HuynhMinhDangTDT/Final_project_iot_smart_home/Thuyet trinh do an tot nghiep2.pptx

## BẢO VỆ ĐỒ ÁN TỐT NGHIỆP

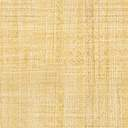
[picture p3: figure]

Tên đề tài:
THỰC HIỆN ỨNG DỤNG Iot TRONG NHÀ THÔNG MINH

GIẢNG VIÊN HƯỚNG DẪN: ThS. Nguyễn Quang Dũng
Người thực hiện : Huỳnh Minh Đăng

## II. Mục đích nghiên cứu

- Thiết kế ra thiết bị IoT có khả năng điểu khiển thông qua internet.
- Thiết kế trang web điều khiển
- Thiết kế app điều khiển
- Thiết kế màn hình hiển thị điều khiển
- Thiết kế phần mềm kết nối camera CCTV nhận diện đám cháy bằng công nghệ AI nhận diện thời gian thực.

## III. Thiết kế đề tài

- Mạch điều khiển IoT

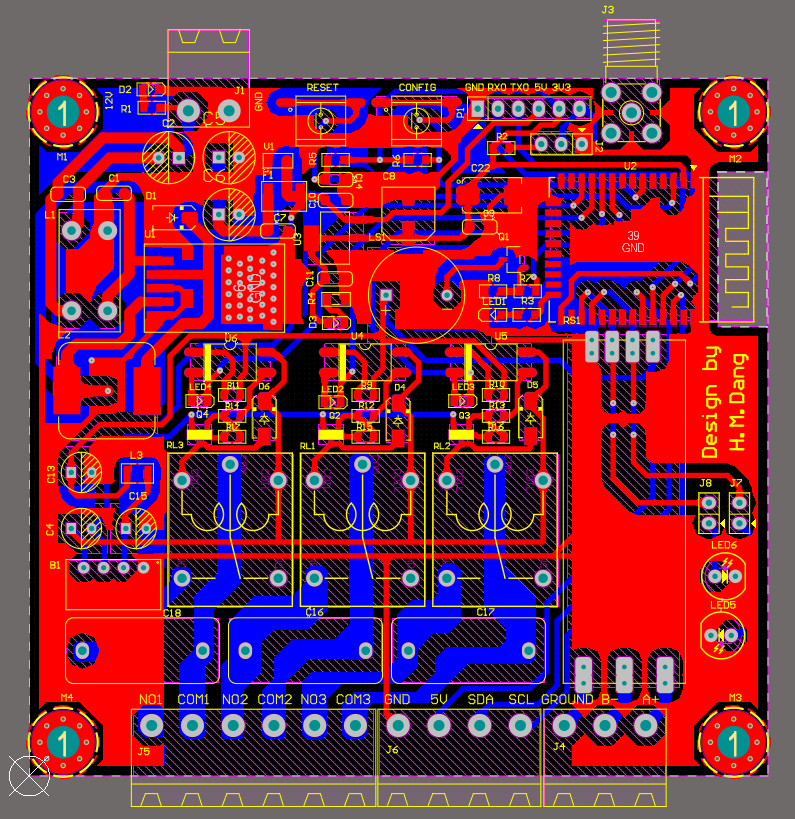
[picture p4: figure]

Phiên bản 1

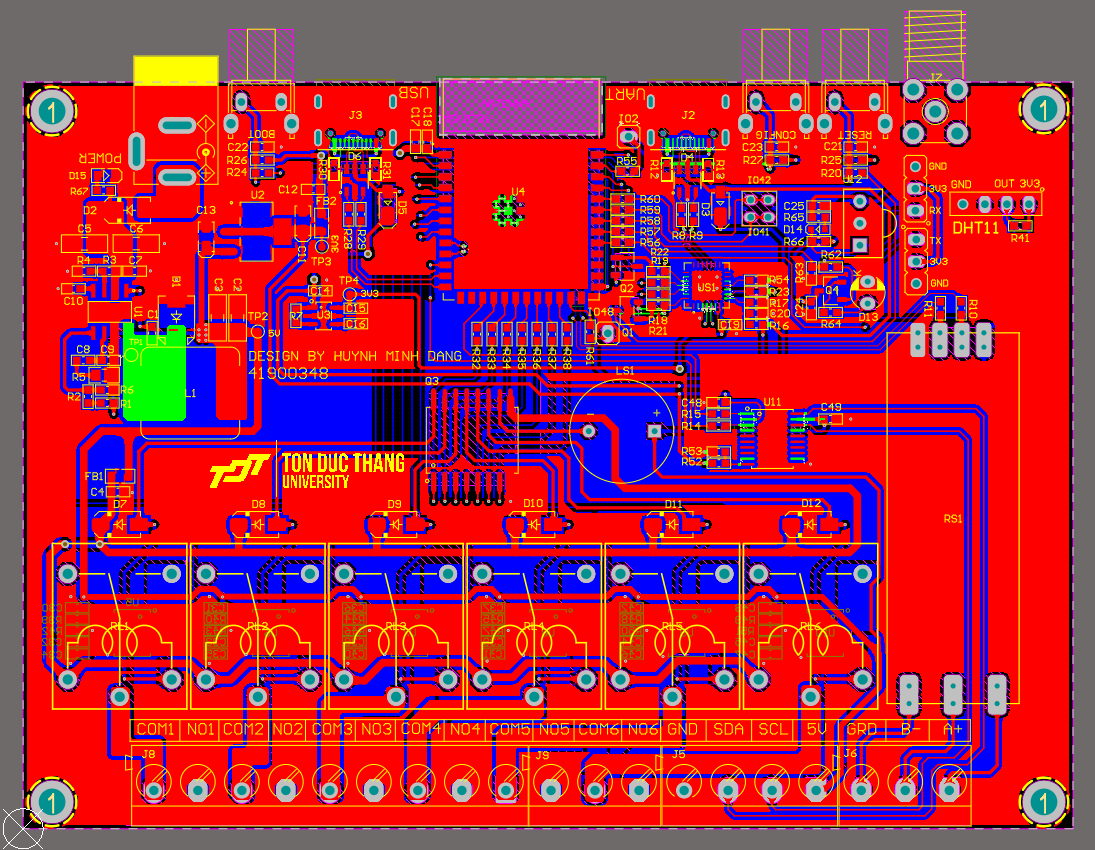
[picture p5: figure]

Phiên bản 2

## II. Thiết kế đề tài

- Mạch thực tế hoàn chỉnh

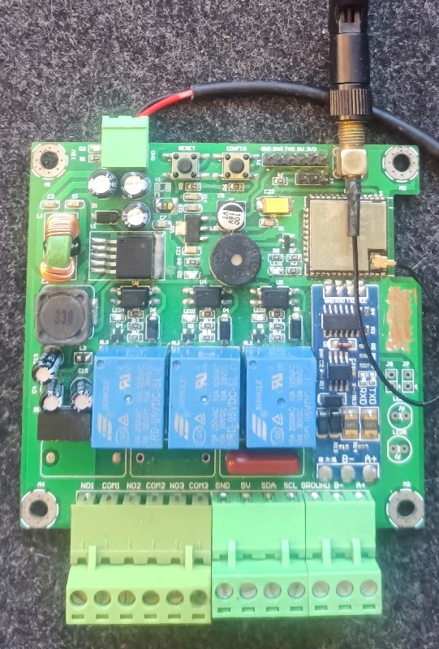
[picture p6: figure]

Phiên bản 1

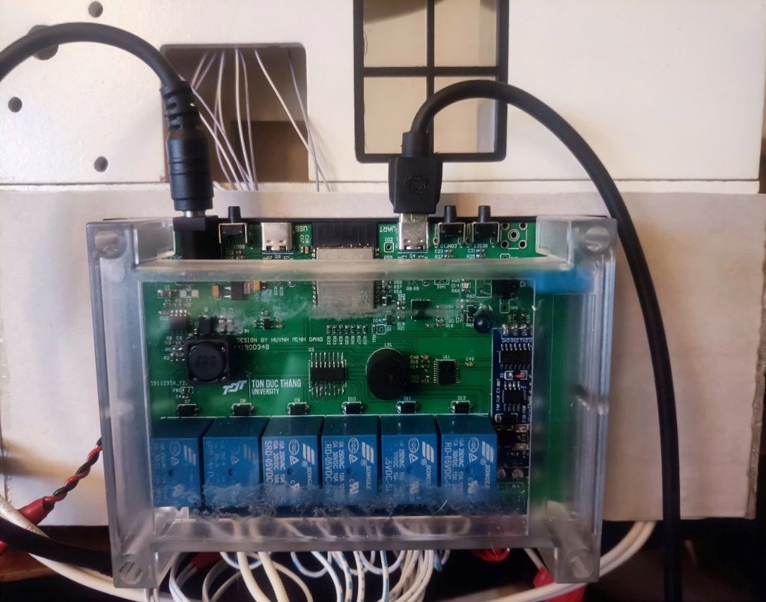
[picture p7: figure]

Phiên bản 2

## II. Thiết kế đề tài

- Thiết kế app điều khiển

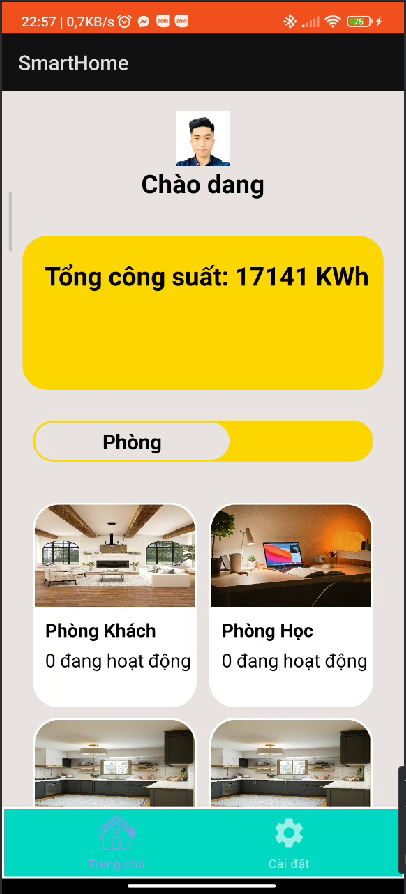
[picture p8: figure]
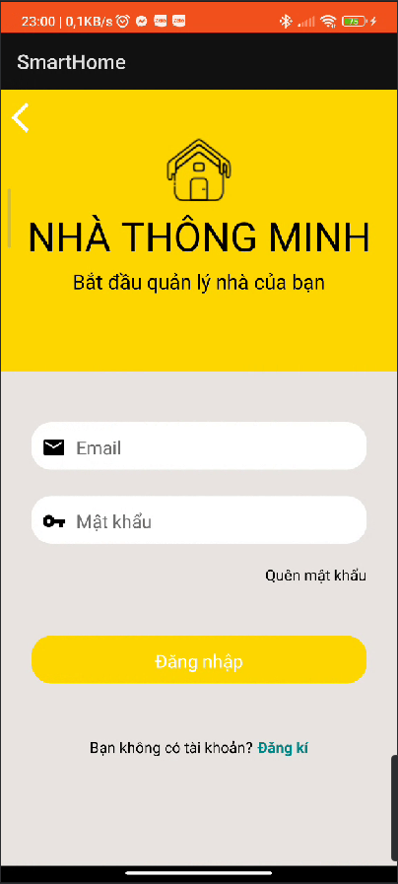
[picture p9: figure]
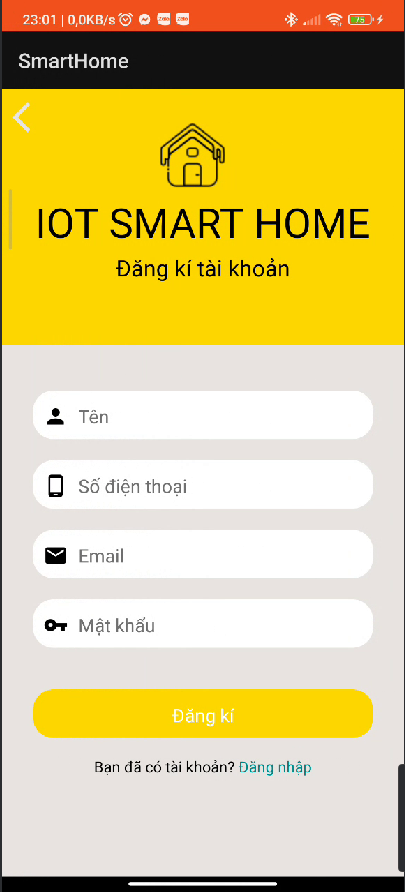
[picture p10: figure]
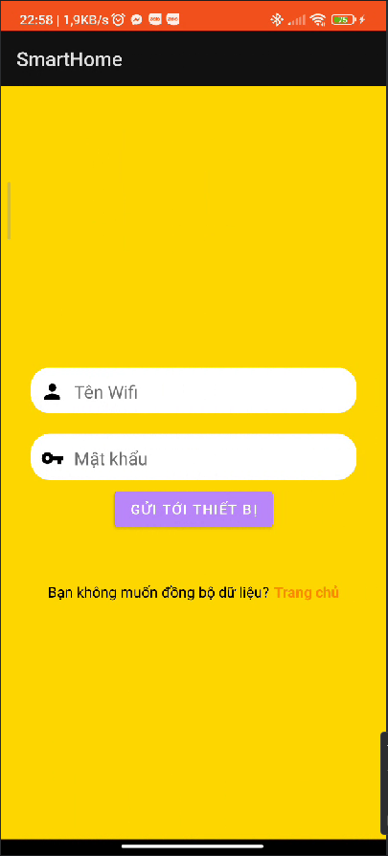
[picture p11: figure]
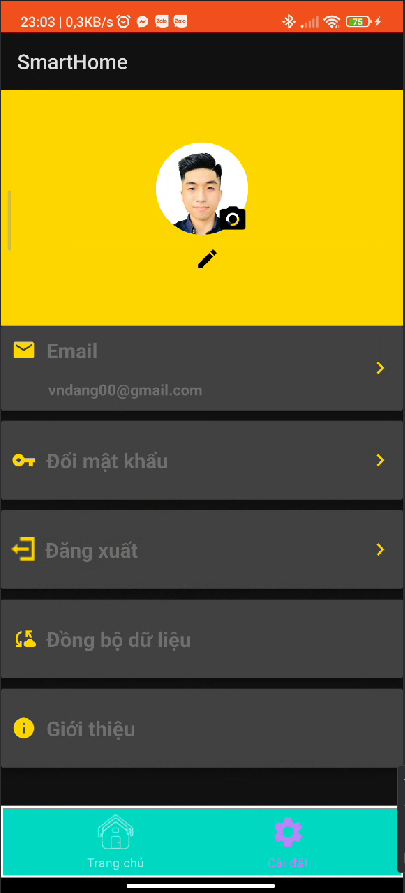
[picture p12: figure]
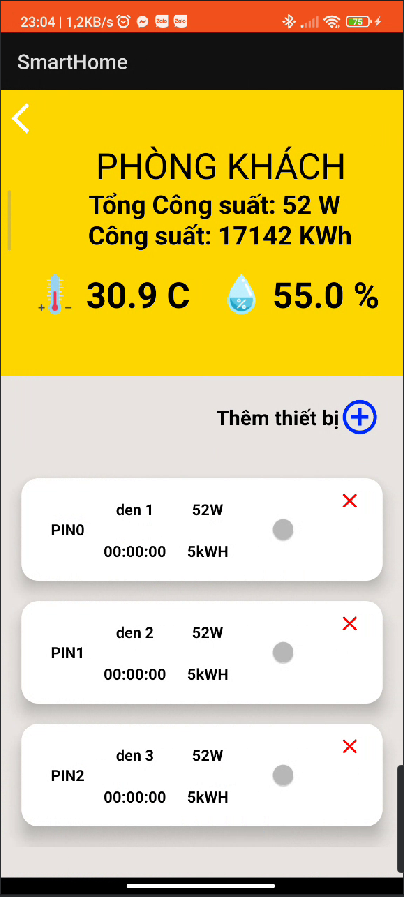
[picture p13: figure]

## II. Thiết kế đề tài

- Thiết kế giao diện màn hình điều khiển

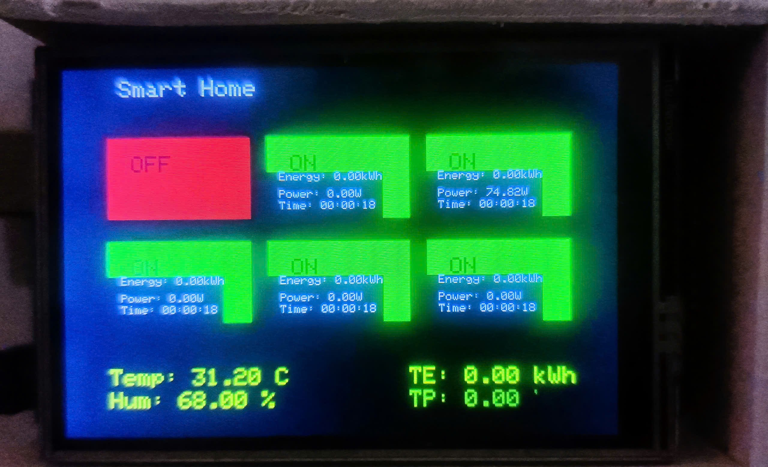
[picture p14: figure]

## II. Thiết kế đề tài

- Thiết kế giao diện trang web

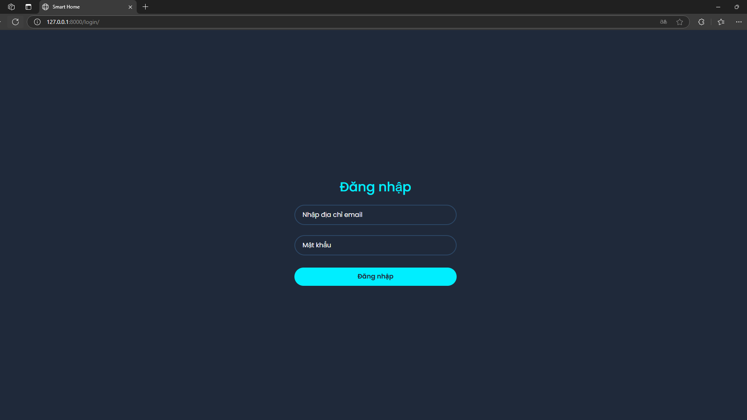
[picture p15: figure]
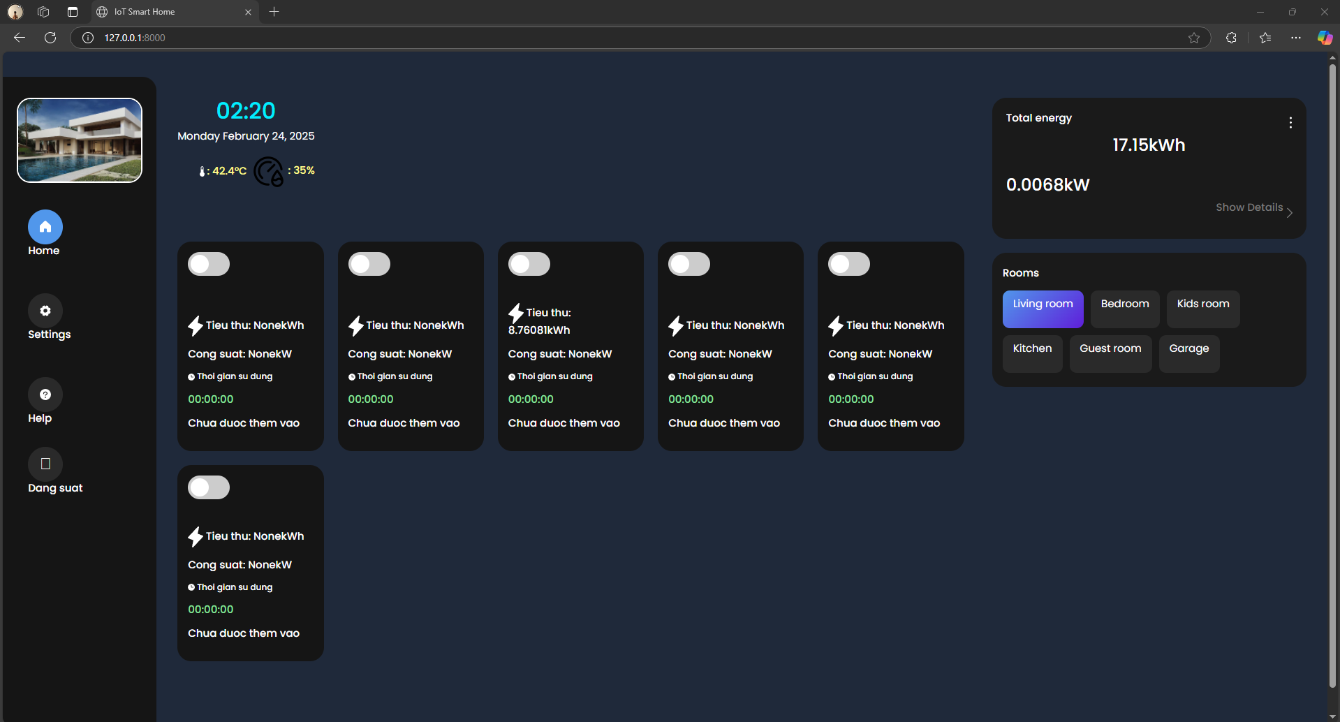
[picture p16: figure]

## II. Thiết kế đề tài

- Thiết kế giao diện phần mềm kết nối camera CCTV

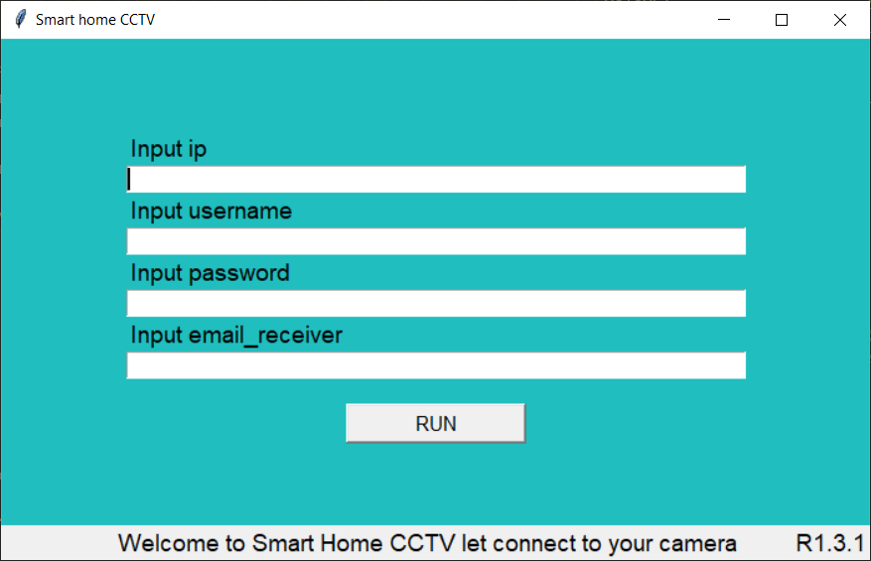
[picture p17: figure]

Giao diện kết nối Camera CCTV

## I. Kết quả

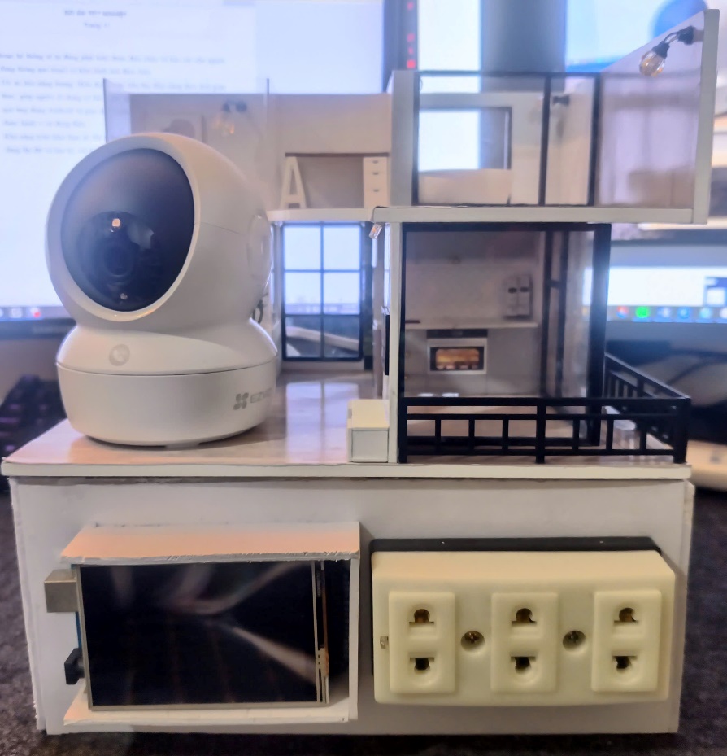
[picture p18: figure]

Mô hình nhà thông minh

## EM CẢM ƠN THẦY CÔ ĐÃ LẮNG NGHE PHẦN THUYẾT TRÌNH CỦA EM Ạ
