HuynhMinhDangTDT/Final_project_iot_smart_home/UI_UX_Fire_Detection/UI_UX_Fire_detection/fire_detect_image.jpg

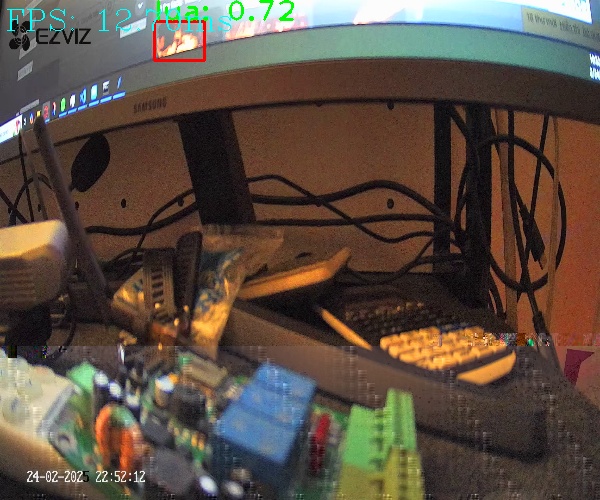
UI_UX_Fire_Detection/UI_UX_Fire_detection/fire_detect_image.jpg
