HuynhMinhDangTDT/Final_project_iot_smart_home/Ve_mach_dien/Do_an_tot_nghiep/Phien_ban_2/PCB_Project_Dangrangto_v2.1/Project Outputs for PCB_Project_Dangrangto/PCB_Project_Dangrangto.xlsx

Comment | Description | Designator | Footprint | Quantity | Link mua hang | Note
100nF_0603_1% | Capacitor, Ceramic, 50V | C1, C4, C12, C17, C21, C22, C23, C25, C30, C31, C32, C33, C36, C37, C38, C39, C42, C43, C44, C45, C48, C49 | tu 0603 | 22 | Link (https://www.thegioiic.com/tu-gom-0603-100nf-0-1uf-50v) |  | ok mua 30 con
47uF_1206_1% | Capacitor, Ceramic, 50V | C2, C3 | tu 1206 | 2 | Link (https://www.thegioiic.com/tu-gom-1206-47uf-16v) |  | ok
4.7uF_1206_1% | Capacitor, Ceramic, 50V | C5, C6 | tu 1206 | 2 | Link (https://www.thegioiic.com/tu-gom-1206-4-7uf-50v) |  | ok
0.01uF_0603_1% | Capacitor, Ceramic, 50V, CAP SMD 0603 | C7, C10 | tu 0603 | 2 | Link (https://www.thegioiic.com/tu-gom-0603-10nf-50v) |  | ok
47pF_0603_1% | Capacitor, Ceramic, 50V | C9 | tu 0603 | 1 | Link (https://www.thegioiic.com/tu-gom-0603-47pf-50v) |  | ok
10uF/10V | CAP, SMD, TAN | C11, C13 | C_TN_3216 | 1 | Link (https://www.thegioiic.com/tu-tantalum-10uf-10v-1206-taja106k010rnj) |  | ok 2 con
1uF_0603_1% | Capacitor, Ceramic, 50V | C14, C15, C20, C24 | tu 0603 | 4 | Link (https://www.thegioiic.com/tu-gom-0603-1uf-50v) |  | ok
22nF_0603_1% | Capacitor, Ceramic, 50V | C16 | tu 0603 | 1 | Link (https://www.thegioiic.com/tu-gom-0603-22nf-50v) |  | ok
22uF_0603_1% | Capacitor, Ceramic, 50V | C18 | tu 0603 | 1 | Link (https://www.thegioiic.com/tu-gom-0603-22uf-10v) |  | ok
10uF_0603_1% | Capacitor, Ceramic, 50V | C19 | tu 0603 | 1 | Link (https://www.thegioiic.com/tu-gom-0603-10uf-25v) |  | ok
1nF_0603_1% | Capacitor, Ceramic, 50V | C34, C35, C40, C41, C46, C47, C8 | tu 0603 | 6 | Link (https://www.thegioiic.com/tu-gom-0603-1nf-50v) |  | ok
SS34_SMB | DIODE, SCHOTTKY, 20V, 3A | D1 | D_SMB | 1 | Link (https://www.thegioiic.com/ss34-smb-schottky-barrier-diodes-40v-3a) |  | ok
SS54_SMA | DIODE, SCHOTTKY, 40V, 3A | D2 | D_SMA | 1 | Link (https://www.thegioiic.com/ss54-sma-diode-shotky-5a-40v) |  | ok
1N5819_DO213 | DIODE, SCHOTTKY, 40V, 1A | D3, D5 | D_SOD123W | 2 | Link (https://www.thegioiic.com/1n5819w-diode-schottky-1a-40v-sod-123) |  | ok
TPUSBLC6-2SC6 | ESD ROHS SOT23-6 DIODES | D4, D6 | SOT-23-6_L2.9-W1.6-P0.95-LS2.8-BR | 2 | Link (https://icdayroi.com/usblc6-2sc6-tvs-diode-5-25v-17v-sot23-6) |  | ok
1N4007 | DIODE, GENERAL PURPOSE, 1000V/1A | D7, D8, D9, D10, D11, D12 | D_SMA | 6 | Link (https://www.thegioiic.com/1n4007-m7-sma-diode-chinh-luu-1a-1kv) |  | ok
TSAL6200 | LED, THD, 3MM, GREEN | D13 | LED3MM | 1 | Link (https://www.thegioiic.com/tsal6200-led-phat-hong-ngoai-5mm-940nm) |  | ok 2 con
LED603RED | LED, SMD, 0603, RED | D14 | LED0603RED | 1 | Link (https://www.thegioiic.com/led-xanh-duong-0603-dan-smd-trong-suot)
LED805RED | LED, SMD, 0805, RED | D15 | LED0805RED | 1 | Link (https://www.thegioiic.com/led-do-0805-dan-smd-trong-suot-harvatek)
FB805 | FERRITE_Bead, 0805, 2A, 50mOhm, 220@100MHz | FB1, FB2 | L0805 | 2 | Link (https://www.thegioiic.com/cbw201209u121t-ferrite-beads-2a-120-ohm-0805) |  | ok
DC_POWER_JACK | CONN, PWR JACK DC, PLUG DIAM 2.0MM RA THD | J1 | JAC_PWR2 | 1 | Link (https://www.thegioiic.com/dc5525-dau-noi-nguon-dc-cai-5525-han-pcb-kim-2-5mm) |  | ok
TYPE-C 16PIN 2MD(073) | 5A 1 Surface Mount 16 Female -25℃~+85℃ Type-C SMD USB Connectors ROHS | J2, J3 | USB-C-SMD_TYPE-C16PIN | 2 | Link (https://www.thegioiic.com/cong-usb-cai-3-1-type-c-16-chan-thang-dan-smd) |  | ok 2 cái
HDRF4 | CONN, HEADER, Female, pitch: 2.54mm, 4POS | J4 | HDR_F_1X4 | 1 | hàng rào cái hoặc đực
CONN_TB4 | CONN, TERMINAL BLOCK, 5.08mm pitch | J5 | TBB_4 | 1 | Link (https://www.thegioiic.com/kf301-4-v-domino-4-chan-thang-5-08mm-300v-10a-han-pcb) |  | ok 1 cái
CONN_TB3 | CONN, TERMINAL BLOCK, 5.08mm pitch | J6, J9 | TBB_3 | 2 | Link (https://www.thegioiic.com/kf301-3-r-domino-3-chan-cong-5-08mm-300v-10a-han-pcb)
SMA | CONN, RF, SMA, Right Angle | J7 | SMA_RA | 1 | khỏi hàn
CONN_TB9 | CONN, TERMINAL BLOCK, 5.08mm pitch | J8 | TBB_9 | 1 | 3 cái CONN_TB9 nối lại |  | ok 5 cái
HDRM1 | CONN, HEADER, Male, pitch: 2.54mm, 1POS | J10, J12 | HDR_M_1 | 2 | hàng rào cái hoặc đực
HDR2M_2X2 | CONN, HEADER, Male, pitch: 2mm, 4POS | J11 | HDR2_M_2X2 | 1 | hàng rào cái hoặc đực đôi
HDRM3 | CONN, HEADER, Male, pitch: 2.54mm, 3POS | J13, J14 | HDR_M_1X3 | 2 | hàng rào cái hoặc đực
6.8uH_CD104 | INDUCTOR, POWER, SMD | L1 | L_10 | 1 | Link (https://icdayroi.com/cuon-cam-6-8uh-cd104) |  | ok
Buzzer | Magnetic Transducer Buzzer | LS1 | Buzzer | 1 | Link (https://www.thegioiic.com/1208-ts-buzzer-coi-chip-tan-so-12x8mm-85db-xuyen-lo) |  | ok
SS8050 | BJT, NPN, 25v, 1.5A, SMD, SOT23 | Q1, Q2 | SOT23_3 | 2 | Link (https://www.thegioiic.com/s8050-j3y-transistor-npn-25v-0-5a-3-chan-sot-23) |  | ok
ULN2003_SOP16 | Darlington, 7-CH, 50V, 0.5A | Q3 | SO_16_W | 1 | Link (https://www.thegioiic.com/umw-uln2003a-transistor-npn-7-ngo-ra-darlington-50v-0-5a-sop-16) |  | ok
S9013 | BJT, NPN, 25v, 1.5A, SMD, SOT23 | Q4 | SOT23_3 | 1 | Link (https://linhkienviet.vn/s9013-sot-23) | shop ở Hà Nội, có thể tìm kiếm shop khác trên shoppe
0R_0603_1% | RES SMD 0603 | R1, R8, R9, R10, R11, R14, R15, R18, R19, R20, R24, R28, R29, R32, R33, R34, R35, R36, R37, R38, R55, R56, R57, R58, R59, R60, R61 | tro smd 0603 | 27 | Link (https://www.thegioiic.com/dien-tro-0-ohm-0603-1-) |  | ok 50 con
6K8_0603_1% | RES SMD 0603 | R2 | tro smd 0603 | 1 | Link (https://icdayroi.com/dien-tro-6k8-0603-1-goi-50-con) |  | ok
10K_0603_1% | RES SMD 0603 | R3, R7, R21, R22, R54, R67 | tro smd 0603 | 6 | Link (https://www.thegioiic.com/dien-tro-10-kohm-0603-1-) |  | ok
1K_0603_1% | RES SMD 0603 | R4, R23, R25, R26, R27, R39, R40, R41, R44, R45, R48, R49, R52, R53, R62, R65 | tro smd 0603 | 16 | Link (https://www.thegioiic.com/dien-tro-1-kohm-0603-1-) |  | ok
29.4K_0805_1% | Dán | R5 | tro smd 0805 | 1 | Link (https://dientutuonglai.com/dien-tro-dan-294k-ohm-0805-1-1.html) |  | not ok
1K3_0603_1% | RES SMD 0603 | R6 | tro smd 0603 | 1 | Link (https://linhkien1993.com/dien-tro-1-3k-0603-1-goi-50-con) |  | not ok
5K1_0603_1% | RESISTOR, SMD | R12, R13, R30, R31 | R0603 | 4 | Link (https://r.search.yahoo.com/_ylt=Awr1Ua0ujn5nNQIAsA9rUwx.;_ylu=Y29sbwNzZzMEcG9zAzIEdnRpZAMEc2VjA3Ny/RV=2/RE=1737556783/RO=10/RU=https%3a%2f%2fshopee.vn%2f%25C4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) |  | not ok
22.1K_0603_1% | RES SMD 0603 | R16 | tro smd 0603 | 1 |  |  | not ok
47.5K_0603_1% | RES SMD 0603 | R17 | tro smd 0603 | 1 |  |  | not ok
2K_0603_1% | RES SMD 0603 | R42, R43, R46, R47, R50, R51 | tro smd 0603 | 6 | Link (https://www.thegioiic.com/dien-tro-2-kohm-0603-5-) |  | ok
22K_0603_1% | RES SMD 0603 | R63 | tro smd 0603 | 1 | Link (https://www.thegioiic.com/dien-tro-22-kohm-0603-1-) |  | ok
11_0603_1% | RES SMD 0603 | R64 | tro smd 0603 | 1 | Link (https://www.thegioiic.com/dien-tro-11-ohm-0805-5-) |  | ok
4K7_0603_1% | RES SMD 0603 | R66 | tro smd 0603 | 1 | Link (https://www.thegioiic.com/dien-tro-4-7-kohm-0603-1-) |  | ok
Relay 5V/10A | Relay SPDT,10A - 12VDC 5 Pin | RL1, RL2, RL3, RL4, RL5, RL6 | RL_10A_5V | 6 | Link (https://icdayroi.com/relay-srd-5vdc-sl-c) |  | ok
RS485_VISION2 |  | RS1 | RS485 - Version2 | 1 | Link (https://icdayroi.com/mach-chuyen-giao-tiep-uart-ttl-rs485) |  | ok
PUSHBUTTON | SWITCH, PUSH BUTTON, TACTILE, THD, SPST, RIGHT | SW1, SW2, SW3 | SWPBT_SPST_R_6X6X10 | 3 | Link (https://www.thegioiic.com/nut-nhan-6x6mm-cao-8mm-4-chan-xuyen-lo-chinh-ngang) |  | ok
TPS54331DR_8SOIC | IC REG BUCK ADJ 3A 8SOIC | U1 | SOIC-8N | 1 | Link (https://www.thegioiic.com/tps54331dr-ic-dieu-chinh-giam-ap-3a-8-soic) |  | ok
LM1117IMP-3.3/NOPB | REG, Linear, LDO1V, 0.8A, SOT-223 | U2 | SOT223_4 | 1 | Link (https://www.thegioiic.com/lm1117imp-3-3-nopb-ic-on-ap-3-3v-800ma-sot-223) |  | ok
RT9193 | REG, Linear, LDO, SOT-23-5 | U3 | SOT23_5 | 1 | Link (https://www.thegioiic.com/rt9193-33gb-ic-on-ap-3-3v-300ma) |  | ok
ESP32-S3-WROOM-1-N8R8 | Bluetooth, WiFi 802.11b/g/n, Bluetooth v5.0 Transceiver Module 2.4GHz PCB Trace Surface Mount | U4 | XCVR_ESP32S3WROOM1N8R8 | 1
ACS712_8SOIC | IC, CURRENT SENSOR, HALL EFFECT | U5, U6, U7, U8, U9, U10 | SO_8 | 6 | tự lựa chọn con dòng mong muốn
TXS0108E | Level Translator, Octal | U11 | SOG65_20 | 1 | Link (https://www.thegioiic.com/txs0108e-mach-chuyen-muc-logic-8-kenh) | mua module về tháo lấy ic | ok
IR_Receiver_1838 | 1A Regulator | U12 | IR_1838 | 1 | Link (https://www.thegioiic.com/tsop1838-led-thu-hong-ngoai) |  | ok
CP2102_QFN28 | USB-UART BRIDGE | US1 | QFN50_28T | 1 | Link (https://www.thegioiic.com/cp2102-ic-usb-controller-12mbps-28-qfn) |  | ok
