HuynhMinhDangTDT/Final_project_iot_smart_home/Ve_mach_dien/Do_an_tot_nghiep/Phien_ban_2/PCB_Project_Dangrangto_v2.1/Pin_Assignment.xlsx

Sheet: Sheet1
Name | No | Type | Function
GND | 1 | P | GND
3V3 | 2 | P | Powersupply
EN | 3 | I | High:on,enablesthechip. Low:off,thechippowersoff. Note:Donot leavetheENpinfloating.
IO4 | 4 | I/O/T | RTC_GPIO4,GPIO4,TOUCH4,ADC1_CH3
IO5 | 5 | I/O/T | RTC_GPIO5,GPIO5,TOUCH5,ADC1_CH4
IO6 | 6 | I/O/T | RTC_GPIO6,GPIO6,TOUCH6,ADC1_CH5
IO7 | 7 | I/O/T | RTC_GPIO7,GPIO7,TOUCH7,ADC1_CH6
IO15 | 8 | I/O/T | RTC_GPIO15,GPIO15,U0RTS,ADC2_CH4,XTAL_32K_P
IO16 | 9 | I/O/T | RTC_GPIO16,GPIO16,U0CTS,ADC2_CH5,XTAL_32K_N
IO17 | 10 | I/O/T | RTC_GPIO17,GPIO17,U1TXD,ADC2_CH6
IO18 | 11 | I/O/T | RTC_GPIO18,GPIO18,U1RXD,ADC2_CH7,CLK_OUT3
IO8 | 12 | I/O/T | RTC_GPIO8,GPIO8,TOUCH8,ADC1_CH7,SUBSPICS1
IO19 | 13 | I/O/T | RTC_GPIO19,GPIO19,U1RTS,ADC2_CH8,CLK_OUT2,USB_D
IO20 | 14 | I/O/T | RTC_GPIO20,GPIO20,U1CTS,ADC2_CH9,CLK_OUT1,USB_D+
IO3 | 15 | I/O/T | RTC_GPIO3,GPIO3,TOUCH3,ADC1_CH2
IO46 | 16 | I/O/T | GPIO46
IO9 | 17 | I/O/T | RTC_GPIO9,GPIO9,TOUCH9,ADC1_CH8,FSPIHD,SUBSPIHD
IO10 | 18 | I/O/T | RTC_GPIO10,GPIO10,TOUCH10,ADC1_CH9,FSPICS0,FSPIIO4, SUBSPICS0
IO11 | 19 | I/O/T | RTC_GPIO11,GPIO11,TOUCH11,ADC2_CH0,FSPID,FSPIIO5, SUBSPID
IO12 | 20 | I/O/T | RTC_GPIO12,GPIO12,TOUCH12,ADC2_CH1,FSPICLK,FSPIIO6, SUBSPICLK
IO13 | 21 | I/O/T | RTC_GPIO13,GPIO13,TOUCH13,ADC2_CH2,FSPIQ,FSPIIO7, SUBSPIQ
IO14 | 22 | I/O/T | RTC_GPIO14,GPIO14,TOUCH14,ADC2_CH3,FSPIWP,FSPIDQS, SUBSPIWP
IO21 | 23 | I/O/T | RTC_GPIO21,GPIO21
IO47 | 24 | I/O/T | SPICLK_P_DIFF,GPIO47,SUBSPICLK_P_DIFF
IO48 | 25 | I/O/T | SPICLK_N_DIFF,GPIO48,SUBSPICLK_N_DIFF
IO45 | 26 | I/O/T | GPIO45
IO0 | 27 | I/O/T | RTC_GPIO0,GPIO0
IO35b | 28 | I/O/T | SPIIO6,GPIO35,FSPID,SUBSPID
IO36b | 29 | I/O/T | SPIIO7,GPIO36,FSPICLK,SUBSPICLK
IO37 b | 30 | I/O/T | SPIDQS,GPIO37,FSPIQ, SUBSPIQ
IO38 | 31 | I/O/T | GPIO38,FSPIWP, SUBSPIWP
IO39 | 32 | I/O/T | MTCK,GPIO39,CLK_OUT3, SUBSPICS1
IO40 | 33 | I/O/T | MTDO,GPIO40,CLK_OUT2
IO41 | 34 | I/O/T | MTDI,GPIO41, CLK_OUT1
IO42 | 35 | I/O/T | MTMS,GPIO42
RXD0 | 36 | I/O/T | U0RXD,GPIO44,CLK_OUT2
TXD0 | 37 | I/O/T | U0TXD,GPIO43, CLK_OUT1
IO2 | 38 | I/O/T | RTC_GPIO2,GPIO2, TOUCH2, ADC1_CH1
IO1 | 39 | I/O/T | RTC_GPIO1,GPIO1, TOUCH1, ADC1_CH0
GND | 40 | P | GND
GND | 41 | P | GND

Sheet: Sheet2
 |  | x | y |  |  |  |  |  |  |  |  |  |  | rotation
Component | Bottom Layer | 6.616 | 26.416 | 0.5 | FALSE | C30 | TRUE | 100nF_0603_1% | FALSE | FALSE | Standard | tu 0603 | 0 | 180 | TRUE | FALSE | FALSE | FALSE | 3.581 sq.mm
Component | Bottom Layer | 6.591 | 22.479 | 0.5 | FALSE | C32 | TRUE | 100nF_0603_1% | FALSE | FALSE | Standard | tu 0603 | 2 | 360 | TRUE | FALSE | FALSE | FALSE | 3.581 sq.mm
Component | Bottom Layer | 6.616 | 21.082 | 0.5 | FALSE | C34 | TRUE | 1nF_0603_1% | FALSE | FALSE | Standard | tu 0603 | 4 | 180 | TRUE | FALSE | FALSE | FALSE | 3.581 sq.mm
Component | Bottom Layer | 6.591 | 25.104 | 0.5 | FALSE | R39 | TRUE | 10K_0603_1% | FALSE | FALSE | Standard | tro smd 0603 | 19 | 360 | TRUE | FALSE | FALSE | FALSE | 3.581 sq.mm
Component | Bottom Layer | 6.616 | 23.791 | 0.5 | FALSE | R42 | TRUE | 10K_0603_1% | FALSE | FALSE | Standard | tro smd 0603 | 22 | 180 | TRUE | FALSE | FALSE | FALSE | 3.581 sq.mm
Component | Bottom Layer | 12.954 | 23.495 | 1.8 | FALSE | U5 | TRUE | ACS712_8SOIC | FALSE | FALSE | Standard | SO_8 | 32 | 180 | TRUE | FALSE | FALSE | FALSE | 44.478 sq.mm

Sheet: Sheet3
Component | Top Layer | 76.6 | 72.4 | 1.27 | FALSE | D3 | TRUE | 1N5819_DO213 | FALSE | FALSE | Standard | D_SOD123W | 7 | 270 | TRUE | FALSE | FALSE | FALSE | 11.44 sq.mm
Component | Top Layer | 72.8 | 75.3 | 0.8 | FALSE | D4 | TRUE | TPUSBLC6-2SC6 | FALSE | FALSE | Standard | SOT-23-6_L2.9-W1.6-P0.95-LS2.8-BR | 8 | 270 | TRUE | FALSE | FALSE | FALSE | 14.411 sq.mm
Component | Top Layer | 72.898 | 82.042 | 1.27 | FALSE | J2 | TRUE | TYPE-C 16PIN 2MD(073) | FALSE | FALSE | Standard | USB-C-SMD_TYPE-C16PIN | 11 | 360 | TRUE | FALSE | FALSE | FALSE | 81.386 sq.mm
Component | Top Layer | 72.1 | 71.4 | 0.5 | FALSE | R8 | TRUE | 0R_0603_1% | FALSE | FALSE | Standard | tro smd 0603 | 15 | 270 | TRUE | FALSE | FALSE | FALSE | 3.581 sq.mm
Component | Top Layer | 73.5 | 71.4 | 0.5 | FALSE | R9 | TRUE | 0R_0603_1% | FALSE | FALSE | Standard | tro smd 0603 | 16 | 270 | TRUE | FALSE | FALSE | FALSE | 3.581 sq.mm
Component | Top Layer | 70.4 | 76.6 | 0.6 | FALSE | R12 | TRUE | 5K1_0603_1% | FALSE | FALSE | Standard | R0603 | 19 | 270 | TRUE | FALSE | FALSE | FALSE | 3.92 sq.mm
Component | Top Layer | 75.188 | 76.581 | 0.6 | FALSE | R13 | TRUE | 5K1_0603_1% | FALSE | FALSE | Standard | R0603 | 20 | 270 | TRUE | FALSE | FALSE | FALSE | 3.92 sq.mm
