HuynhMinhDangTDT/Final_project_iot_smart_home/(list of files, drawings)

Other design files:
Ve_mach_dien/Do_an_tot_nghiep/PCB_Project_Final/PCB_Project_Final.PrjPcb
Ve_mach_dien/Do_an_tot_nghiep/PCB_Project_Final/SCH_Project_Final.SchDoc
Ve_mach_dien/Do_an_tot_nghiep/Phien_ban_2/PCB_Project_Dangrangto_v2.0/MCU_ESP32_S3.SchDoc
Ve_mach_dien/Do_an_tot_nghiep/Phien_ban_2/PCB_Project_Dangrangto_v2.0/OUTPUT_RELAY.SchDoc
Ve_mach_dien/Do_an_tot_nghiep/Phien_ban_2/PCB_Project_Dangrangto_v2.0/PCB_Project_Dangrangto.PrjPcb
Ve_mach_dien/Do_an_tot_nghiep/Phien_ban_2/PCB_Project_Dangrangto_v2.0/PCB_Project_Dangrangto.SCHLIB
Ve_mach_dien/Do_an_tot_nghiep/Phien_ban_2/PCB_Project_Dangrangto_v2.0/PCB_Project_Dangrangto/MCU_ESP32_S3.SchDoc
Ve_mach_dien/Do_an_tot_nghiep/Phien_ban_2/PCB_Project_Dangrangto_v2.0/PCB_Project_Dangrangto/OUTPUT_RELAY.SchDoc
Ve_mach_dien/Do_an_tot_nghiep/Phien_ban_2/PCB_Project_Dangrangto_v2.0/PCB_Project_Dangrangto/PCB_Project_Dangrangto.PrjPcb
Ve_mach_dien/Do_an_tot_nghiep/Phien_ban_2/PCB_Project_Dangrangto_v2.0/PCB_Project_Dangrangto/PCB_Project_Dangrangto.SCHLIB
Ve_mach_dien/Do_an_tot_nghiep/Phien_ban_2/PCB_Project_Dangrangto_v2.0/PCB_Project_Dangrangto/Power.SchDoc
Ve_mach_dien/Do_an_tot_nghiep/Phien_ban_2/PCB_Project_Dangrangto_v2.0/PCB_Project_Dangrangto/Protocol.SchDoc
Ve_mach_dien/Do_an_tot_nghiep/Phien_ban_2/PCB_Project_Dangrangto_v2.0/PCB_Project_Dangrangto/SENSOR.SchDoc
Ve_mach_dien/Do_an_tot_nghiep/Phien_ban_2/PCB_Project_Dangrangto_v2.0/Power.SchDoc
Ve_mach_dien/Do_an_tot_nghiep/Phien_ban_2/PCB_Project_Dangrangto_v2.0/Protocol.SchDoc
Ve_mach_dien/Do_an_tot_nghiep/Phien_ban_2/PCB_Project_Dangrangto_v2.0/SENSOR.SchDoc
Ve_mach_dien/Do_an_tot_nghiep/Phien_ban_2/PCB_Project_Dangrangto_v2.1/MCU_ESP32_S3.SchDoc
Ve_mach_dien/Do_an_tot_nghiep/Phien_ban_2/PCB_Project_Dangrangto_v2.1/OUTPUT_RELAY.SchDoc
Ve_mach_dien/Do_an_tot_nghiep/Phien_ban_2/PCB_Project_Dangrangto_v2.1/PCB_Project_Dangrangto.PrjPcb
Ve_mach_dien/Do_an_tot_nghiep/Phien_ban_2/PCB_Project_Dangrangto_v2.1/PCB_Project_Dangrangto.SCHLIB
Ve_mach_dien/Do_an_tot_nghiep/Phien_ban_2/PCB_Project_Dangrangto_v2.1/Power.SchDoc
Ve_mach_dien/Do_an_tot_nghiep/Phien_ban_2/PCB_Project_Dangrangto_v2.1/Protocol.SchDoc
Ve_mach_dien/Do_an_tot_nghiep/Phien_ban_2/PCB_Project_Dangrangto_v2.1/SENSOR.SchDoc
