HuynhMinhDangTDT/Final_project_iot_smart_home/ESP32IotSmarthome_v2.1/src/connectWiFi.h

#include "WiFi.h"
#include "EEPROM.h" 
#include "WebServer.h"
#define BUZZER_PIN 47

WebServer server(80);
String content;
String st;
int statusCode;



void createWebServer(void);
void setupAP(void);
void launchWeb(void); 

void launchWeb()
{
  Serial.println("");
  if (WiFi.status() == WL_CONNECTED)
    Serial.println("WiFi connected");
    Serial.print("Local IP: ");
    Serial.println(WiFi.localIP());
    Serial.print("SoftAP IP: ");
    Serial.println(WiFi.softAPIP());
    createWebServer();
    // Start the server
    server.begin();
    Serial.println("Server started");
}


void setupAP(void)
{
  WiFi.mode(WIFI_STA);
  WiFi.disconnect();
  delay(100);
  int n = WiFi.scanNetworks();
  Serial.println("scan done");
  if (n == 0)
    Serial.println("no networks found");
  else
  {
    Serial.print(n);
    Serial.println(" networks found");
    for (int i = 0; i < n; ++i)
    {
      // Print SSID and RSSI for each network found
      Serial.print(i + 1);
      Serial.print(": ");
      Serial.print(WiFi.SSID(i));
      Serial.print(" (");
      Serial.print(WiFi.RSSI(i));
      Serial.print(")");
      Serial.println((WiFi.encryptionType(i) == WIFI_AUTH_OPEN) ? " " : "*");
      delay(10);
    }
  }
  Serial.println("");
  st = "<ol>";
  for (int i = 0; i < n; ++i)
  {
    // Print SSID and RSSI for each network found
    st += "<li>";
    st += WiFi.SSID(i);
    st += " (";
    st += WiFi.RSSI(i);

    st += ")";
    st += (WiFi.encryptionType(i) == WIFI_AUTH_OPEN) ? " " : "*";
    st += "</li>";
  }
  st += "</ol>";
  delay(100);
  WiFi.softAP("SmartHome", "");
  Serial.println("softap");
  launchWeb();
  Serial.println("over");
}


void createWebServer()
{
 {
    server.on("/", []() {

      IPAddress ip = WiFi.softAPIP();
      String ipStr = String(ip[0]) + '.' + String(ip[1]) + '.' + String(ip[2]) + '.' + String(ip[3]);
      content = "<!DOCTYPE HTML>\r\n<html>Hello from ESP8266 at ";
      content += "<form action=\"/scan\" method=\"POST\"><input type=\"submit\" value=\"scan\"></form>";
      content += ipStr;
      content += "<p>";
      content += st;
      content += "</p><form method='get' action='post'><label>SSID: </label><input name='ssid' length=32><input name='pass' length=64><input type='submit'></form>";
      content += "</html>";
      server.send(200, "text/html", content);
    });
    server.on("/scan", []() {
      //setupAP();
      IPAddress ip = WiFi.softAPIP();
      String ipStr = String(ip[0]) + '.' + String(ip[1]) + '.' + String(ip[2]) + '.' + String(ip[3]);

      content = "<!DOCTYPE HTML>\r\n<html>go back";
      server.send(200, "text/html", content);
    });

    server.on("/post", []() {
      String qsid = server.arg("ssid");
      String qpass = server.arg("pass");
      String quserid=server.arg("userid");
      if (qsid.length() > 0 && qpass.length() > 0 && quserid.length() > 0) {
        Serial.println("clearing eeprom");

        pinMode(BUZZER_PIN, OUTPUT);

        for (int i = 0; i < 96; ++i) 
          EEPROM.write(i, 0);
        
        Serial.println(qsid);
        Serial.println("");
        Serial.println(qpass);
        Serial.println("");
        Serial.println(quserid);
        Serial.println("");

        Serial.println("writing eeprom ssid:");
        for (int i = 0; i < qsid.length(); ++i)
        {
          EEPROM.write(i,qsid[i]); 
          Serial.print("Wrote: ");
          Serial.println(qsid[i]);
        }
        Serial.println("writing eeprom pass:");
        for (int i = 0; i < qpass.length(); ++i)
        {
          EEPROM.write(32+i,qpass[i]);
          Serial.print("Wrote: ");
          Serial.println(qpass[i]);
        }
        Serial.println("writing eeprom userid:");
        for (int i = 0; i < quserid.length(); ++i)
        {
          EEPROM.write(64+i,quserid[i]);
          Serial.print("Wrote: ");
          Serial.println(quserid[i]);
        }
        EEPROM.commit();

        content = "{\"Success\":\"saved to eeprom... reset to boot into new wifi\"}";
        statusCode = 200;
        digitalWrite(BUZZER_PIN, HIGH); // turn on
        delay (200);
        digitalWrite(BUZZER_PIN, LOW);
        delay (200);
        digitalWrite(BUZZER_PIN, HIGH); // turn on
        delay (200);
        digitalWrite(BUZZER_PIN, LOW);
        delay (200);
        digitalWrite(BUZZER_PIN, HIGH); // turn on
        delay (200);
        digitalWrite(BUZZER_PIN, LOW);
        delay (200);
        ESP.restart();
      } else {
        content = "{\"Error\":\"404 not found\"}";
        statusCode = 404;
        Serial.println("Sending 404");
        digitalWrite(BUZZER_PIN, HIGH); // turn on
        delay (200);
        digitalWrite(BUZZER_PIN, LOW);
        delay (200);
        digitalWrite(BUZZER_PIN, HIGH); // turn on
        delay (200);
        digitalWrite(BUZZER_PIN, LOW);
        delay (200);
      }
      server.sendHeader("Access-Control-Allow-Origin", "*");
      server.send(statusCode, "application/json", content);

    });
  } 
}
